dev-netinho/pdf-do-chatgpt/Pacoca_Prototipo_CAD_v1/step/corte_Y0_000.step

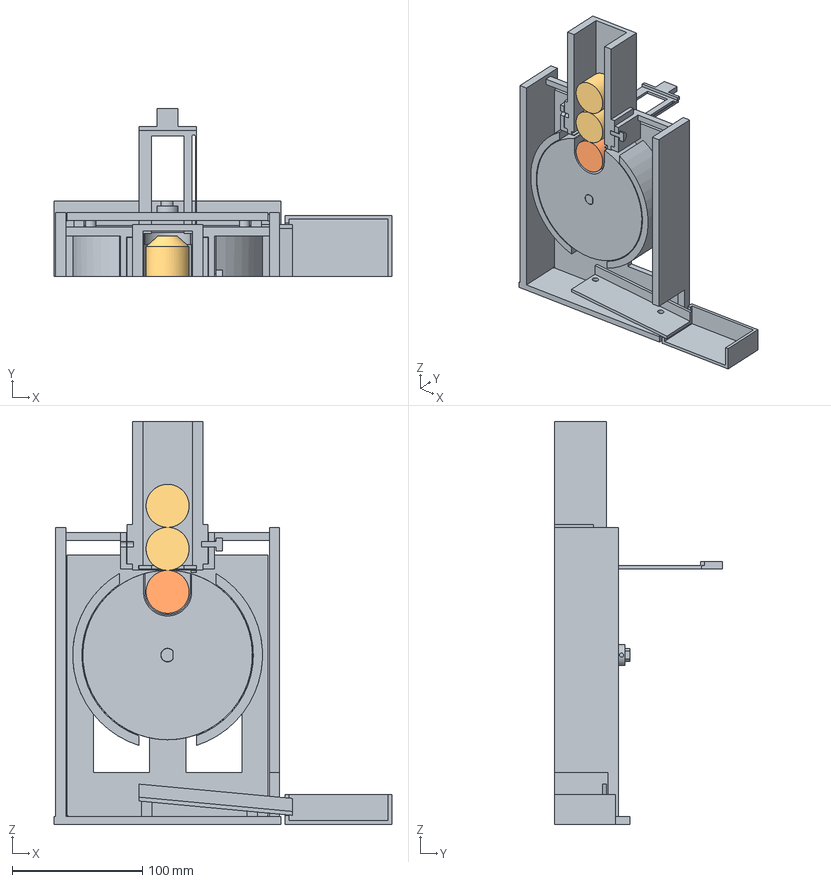
[picture p7: CAD file, 2026-10-01]
Pacoca_Prototipo_CAD_v1/step/corte_Y0_000.step
259.0 x 129.0 x 309.2 mm
04_roda_corte
01_cartucho_corte
02_comporta_U_corte
16_retencao_comporta_M2_corte
03_dock_corte
05_aro_fixo_corte
06_eixo_D_corte
12_colar_traseiro_corte
08_calha_corte
09_bandeja_corte
15_pino_cartucho_corte
REF_entrega_1_corte
REF_estoque_2_corte
REF_estoque_3_corte
