dev-netinho/pdf-do-chatgpt/Pacoca_Prototipo_CAD_v1/montagem_completa.step

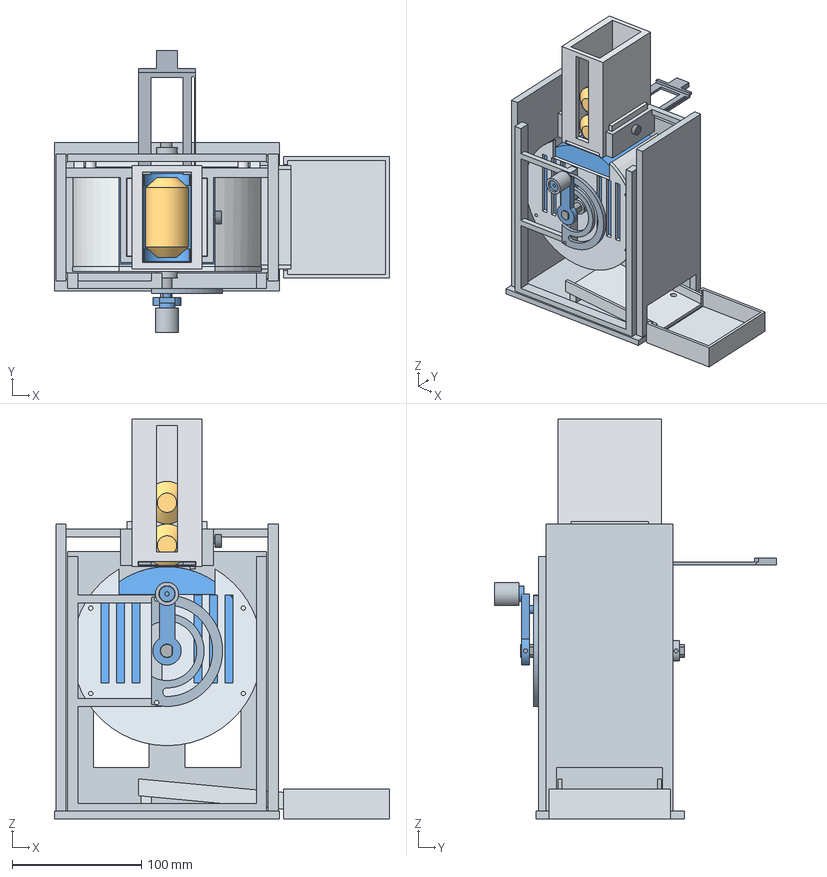
[picture p9: CAD file, 2026-10-01]
Pacoca_Prototipo_CAD_v1/montagem_completa.step
259.0 x 218.0 x 309.2 mm
04_roda
01_cartucho
02_comporta_U
16_retencao_comporta_M2
03_dock
05_aro_fixo
10_tampa_inspecao
06_eixo_D
11_colar_frontal
12_colar_traseiro
07_manivela
13_punho
14_batentes_0_180
08_calha
09_bandeja
15_pino_cartucho
REF_entrega_1
REF_estoque_2
REF_estoque_3
