dev-netinho/pdf-do-chatgpt/Pacoca_Prototipo_CAD_v1/step/09_bandeja.step

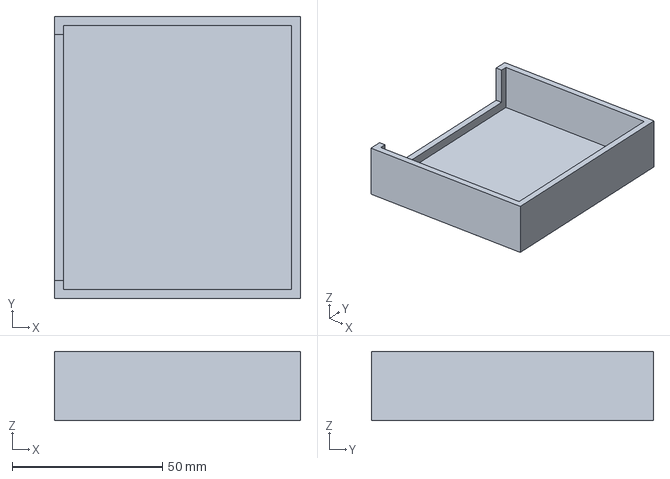
[picture p10: CAD file, 2026-10-01]
Pacoca_Prototipo_CAD_v1/step/09_bandeja.step
82.0 x 94.0 x 23.0 mm
