dev-netinho/pdf-do-chatgpt/Pacoca_Prototipo_CAD_v1/step/13_punho.step

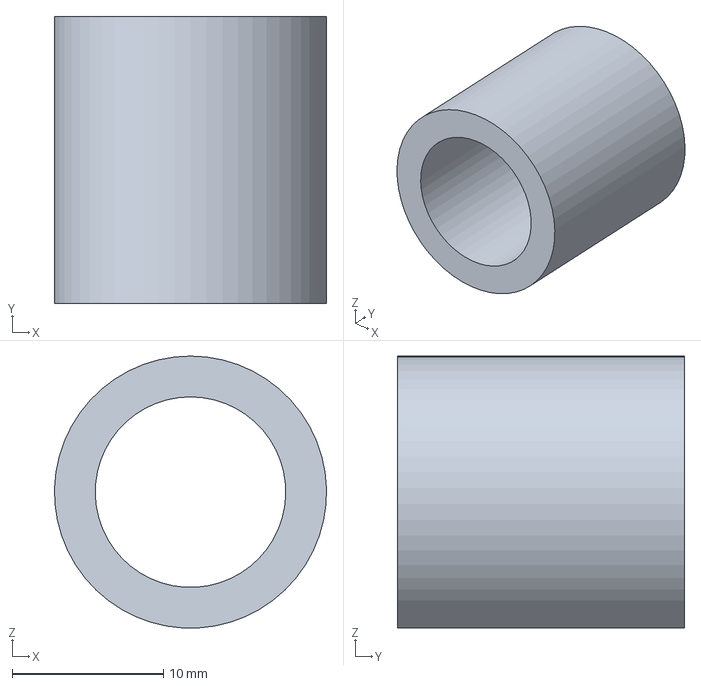
[picture p11: CAD file, 2026-10-01]
Pacoca_Prototipo_CAD_v1/step/13_punho.step
18.0 x 19.0 x 18.0 mm
