dev-netinho/pdf-do-chatgpt/Pacoca_Prototipo_CAD_v1/step/05_aro_fixo.step

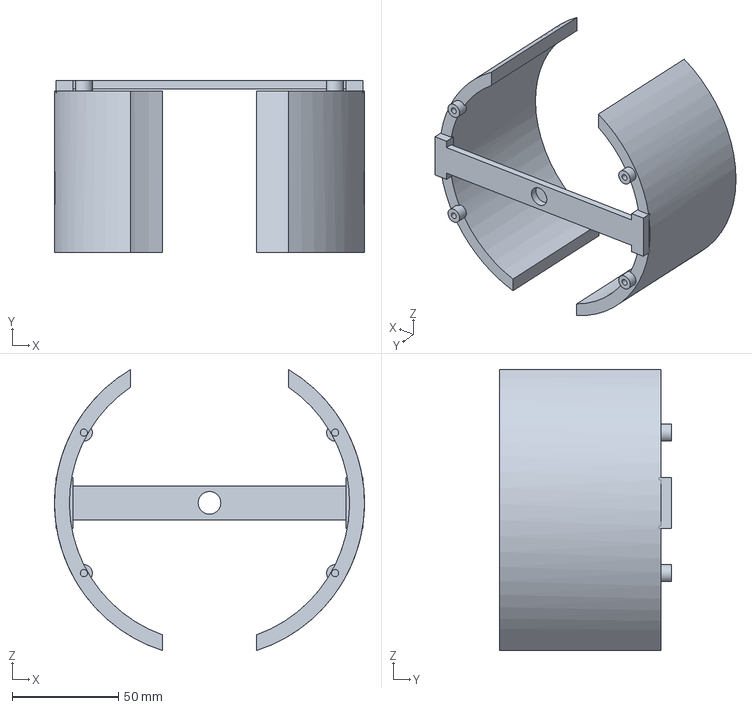
[picture p12: CAD file, 2026-10-01]
Pacoca_Prototipo_CAD_v1/step/05_aro_fixo.step
145.6 x 81.0 x 132.1 mm
