dev-netinho/pdf-do-chatgpt/Pacoca_Prototipo_CAD_v1/step/06_eixo_D.step

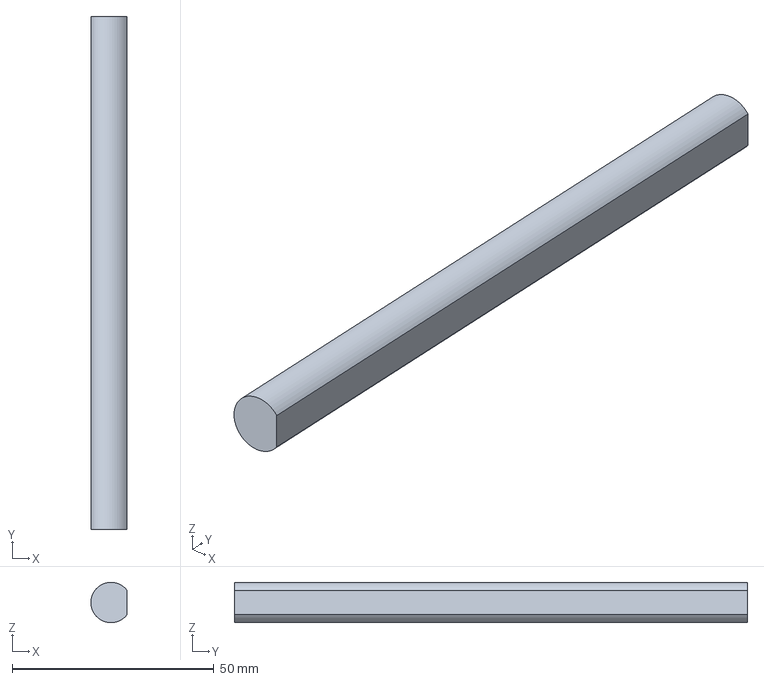
[picture p13: CAD file, 2026-10-01]
Pacoca_Prototipo_CAD_v1/step/06_eixo_D.step
9.00 x 127.0 x 9.99 mm
