dev-netinho/pdf-do-chatgpt/Pacoca_Prototipo_CAD_v1/step/11_colar_frontal.step

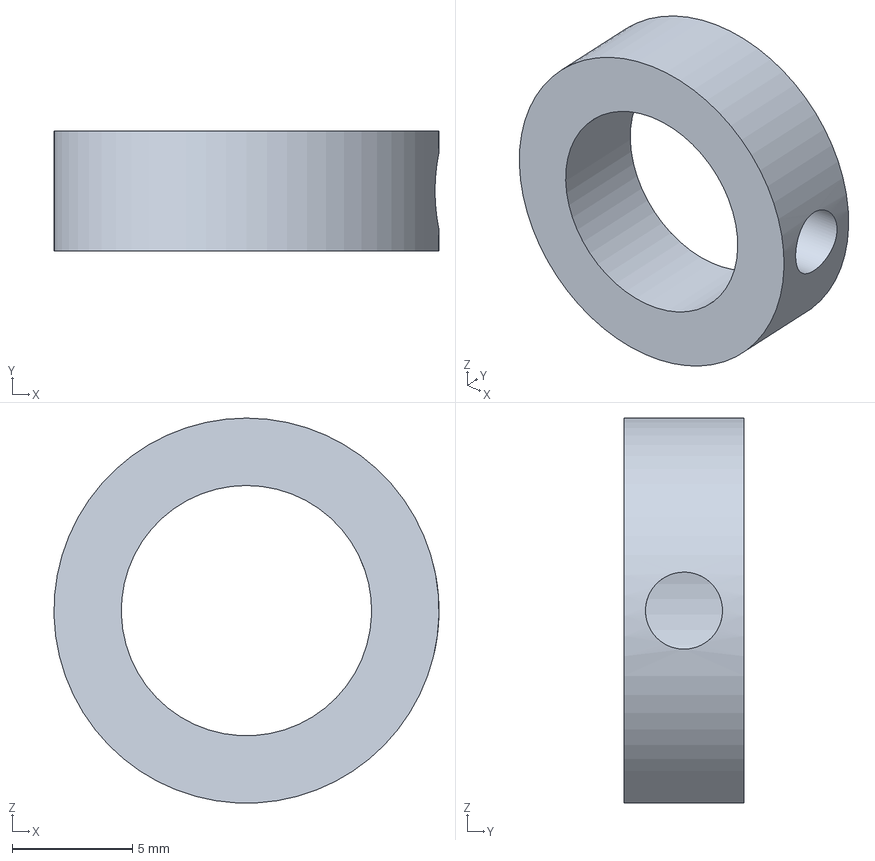
[picture p14: CAD file, 2026-10-01]
Pacoca_Prototipo_CAD_v1/step/11_colar_frontal.step
16.0 x 5.00 x 16.0 mm
