dev-netinho/pdf-do-chatgpt/Pacoca_Prototipo_CAD_v1/step/REF_espaco_futuro_motor.step

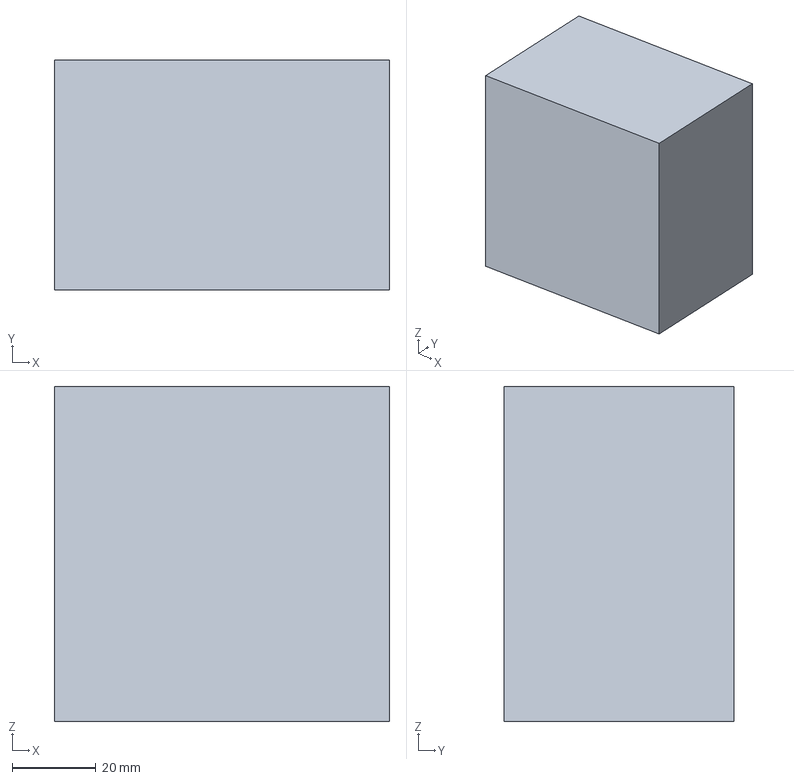
[picture p15: CAD file, 2026-10-01]
Pacoca_Prototipo_CAD_v1/step/REF_espaco_futuro_motor.step
80.0 x 55.0 x 80.0 mm
