dev-netinho/pdf-do-chatgpt/Pacoca_Prototipo_CAD_v1/step/16_retencao_comporta_M2.step

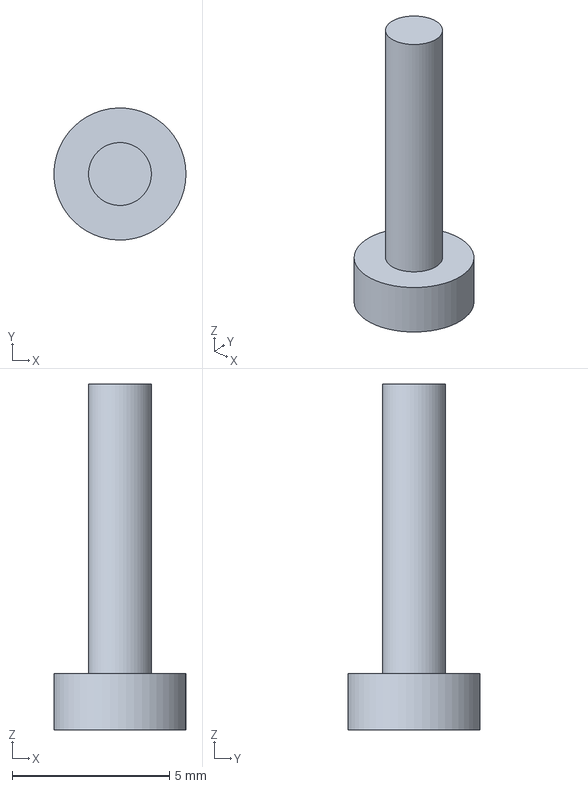
[picture p16: CAD file, 2026-10-01]
Pacoca_Prototipo_CAD_v1/step/16_retencao_comporta_M2.step
4.20 x 4.20 x 11.0 mm
