dev-netinho/pdf-do-chatgpt/Pacoca_Prototipo_CAD_v1/step/04_roda.step

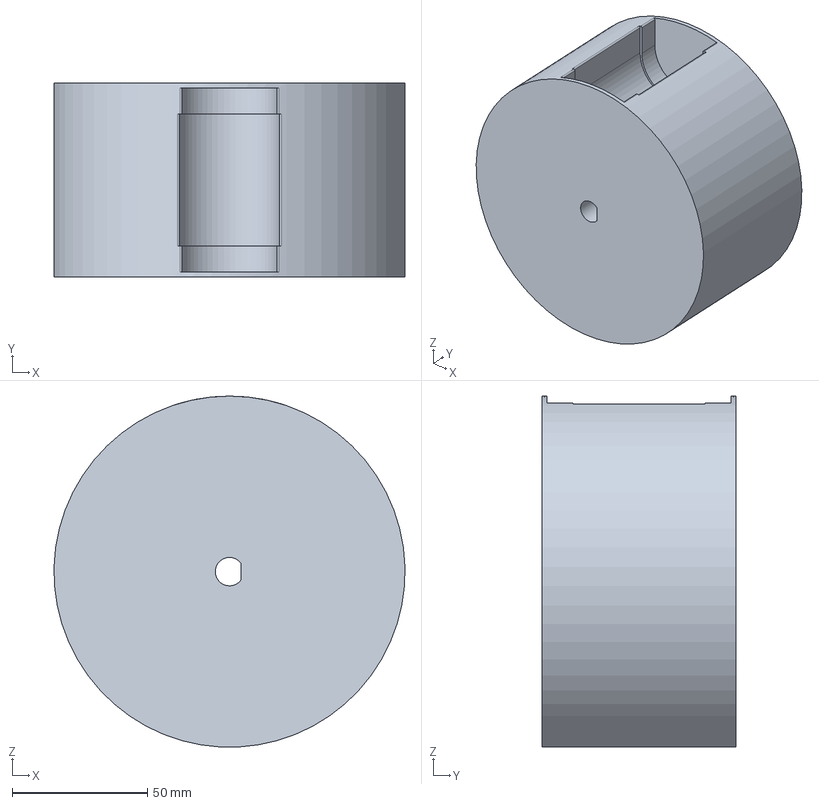
[picture p17: CAD file, 2026-10-01]
Pacoca_Prototipo_CAD_v1/step/04_roda.step
130.0 x 72.0 x 129.9 mm
