dev-netinho/pdf-do-chatgpt/Pacoca_Prototipo_CAD_v1/step/08_calha.step

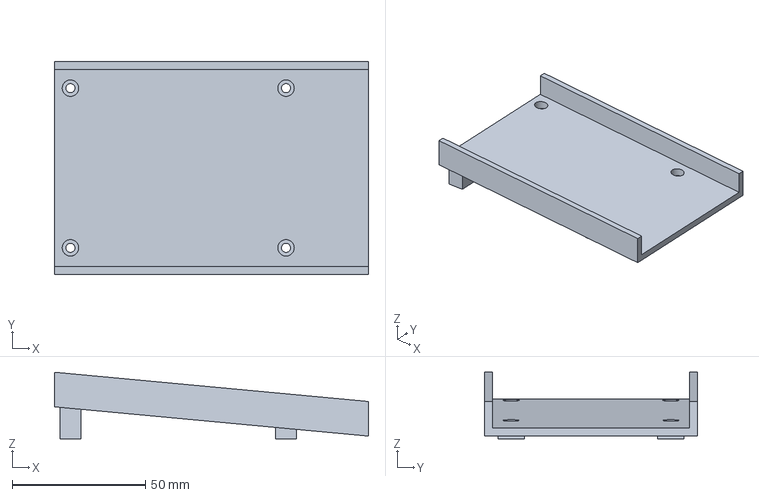
[picture p18: CAD file, 2026-10-01]
Pacoca_Prototipo_CAD_v1/step/08_calha.step
118.0 x 80.0 x 25.0 mm
