dev-netinho/pdf-do-chatgpt/Pacoca_Prototipo_CAD_v1/step/07_manivela.step

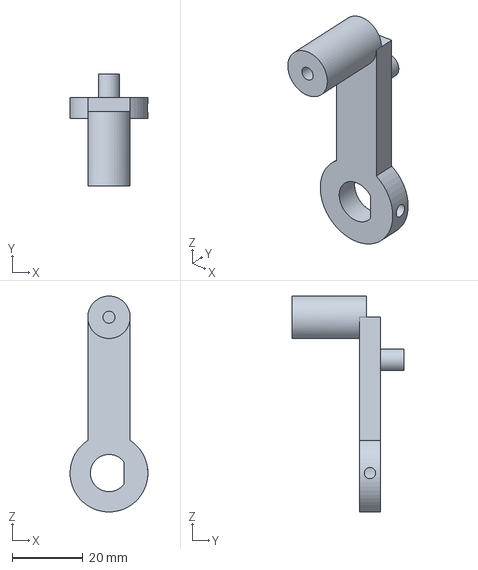
[picture p19: CAD file, 2026-10-01]
Pacoca_Prototipo_CAD_v1/step/07_manivela.step
22.0 x 31.6 x 61.0 mm
