dev-netinho/pdf-do-chatgpt/Pacoca_Prototipo_CAD_v1/step/14_batentes_0_180.step

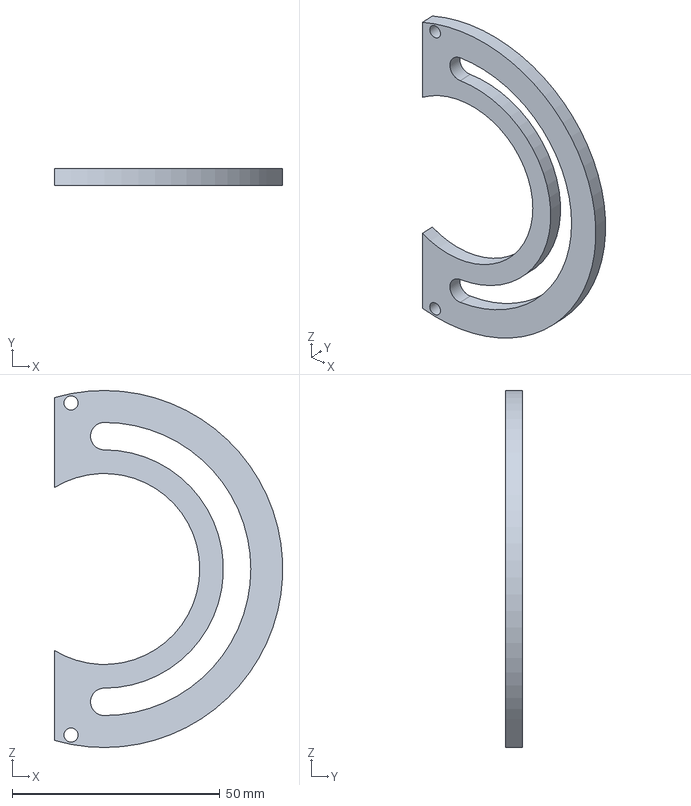
[picture p21: CAD file, 2026-10-01]
Pacoca_Prototipo_CAD_v1/step/14_batentes_0_180.step
55.0 x 4.00 x 86.0 mm
