dev-netinho/pdf-do-chatgpt/Pacoca_Prototipo_CAD_v1/step/02_comporta_U.step

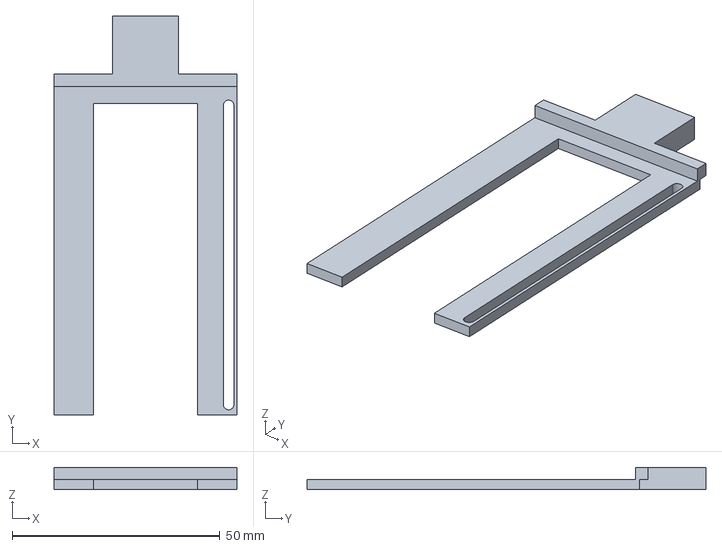
[picture p23: CAD file, 2026-10-01]
Pacoca_Prototipo_CAD_v1/step/02_comporta_U.step
44.0 x 96.0 x 5.40 mm
