dev-netinho/pdf-do-chatgpt/Pacoca_Prototipo_CAD_v1/step/03_dock.step

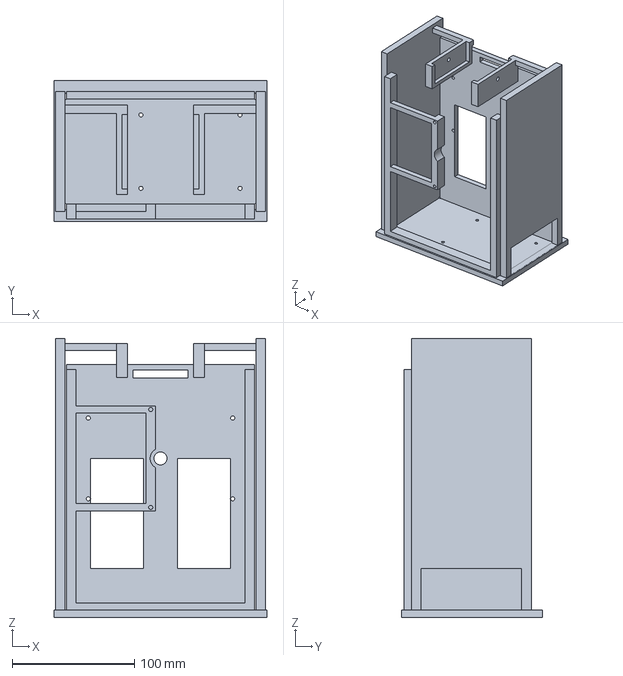
[picture p24: CAD file, 2026-10-01]
Pacoca_Prototipo_CAD_v1/step/03_dock.step
174.0 x 115.0 x 228.0 mm
