dev-netinho/pdf-do-chatgpt/Pacoca_Prototipo_CAD_v1/step/01_cartucho.step

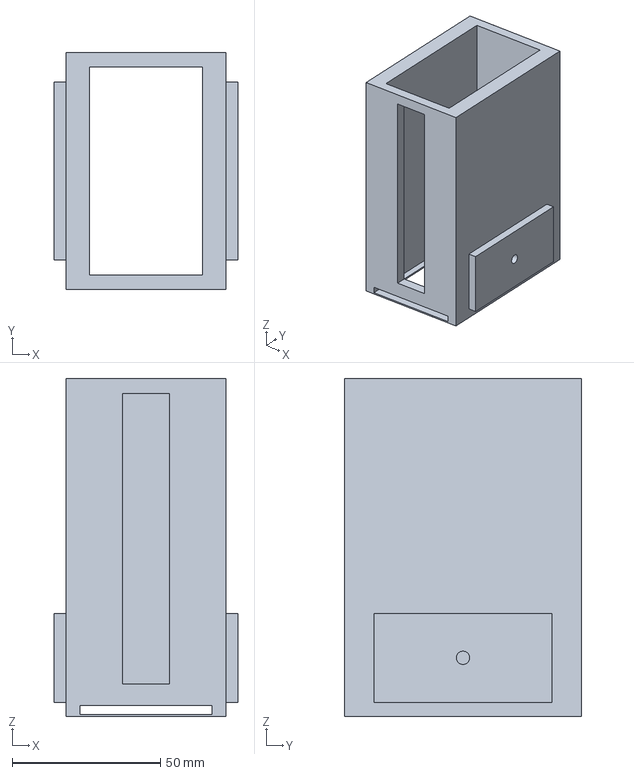
[picture p25: CAD file, 2026-10-01]
Pacoca_Prototipo_CAD_v1/step/01_cartucho.step
62.0 x 80.0 x 114.0 mm
