dev-netinho/pdf-do-chatgpt/Pacoca_Prototipo_CAD_v1/step/10_tampa_inspecao.step

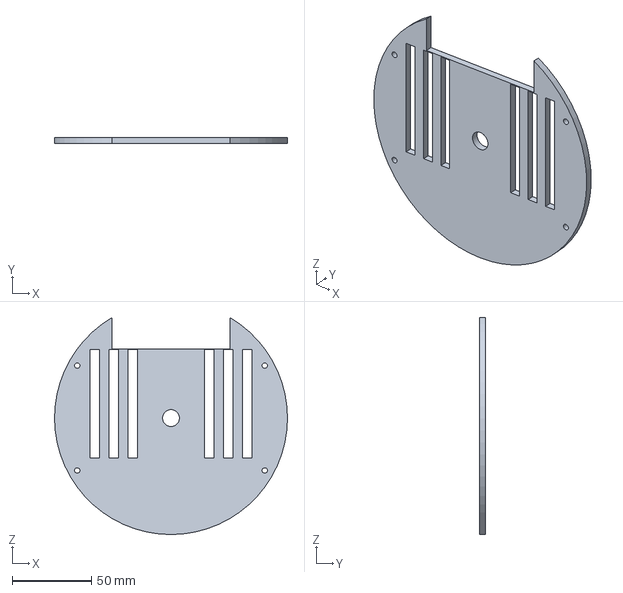
[picture p26: CAD file, 2026-10-01]
Pacoca_Prototipo_CAD_v1/step/10_tampa_inspecao.step
146.6 x 4.00 x 136.6 mm
