dev-netinho/pdf-do-chatgpt/Pacoca_Prototipo_CAD_v1/step/15_pino_cartucho.step

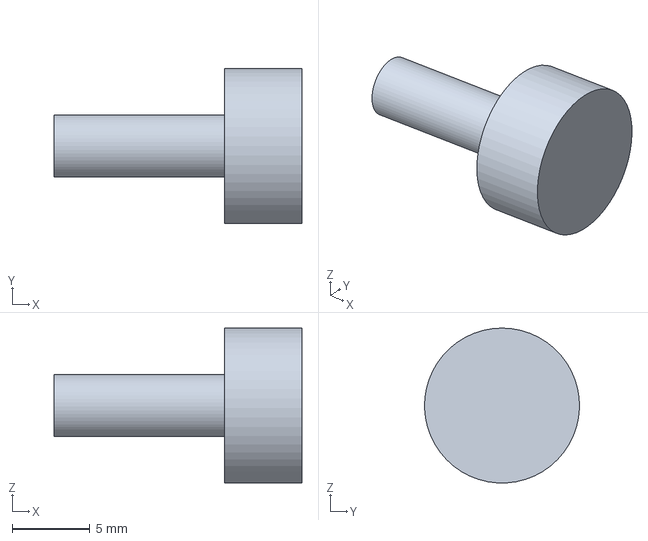
[picture p27: CAD file, 2026-10-01]
Pacoca_Prototipo_CAD_v1/step/15_pino_cartucho.step
16.0 x 10.00 x 9.99 mm
