dev-netinho/pdf-do-chatgpt/(list of files, cad)

Other CAD files:
Pacoca_Prototipo_CAD_v1/step/02_carga_0_montagem.step
Pacoca_Prototipo_CAD_v1/step/12_colar_traseiro.step
Pacoca_Prototipo_CAD_v1/step/04b_retorno_vazio_000.step
Pacoca_Prototipo_CAD_v1/step/06_segunda_entrega_180_montagem.step
Pacoca_Prototipo_CAD_v1/step/04b_retorno_vazio_025.step
Pacoca_Prototipo_CAD_v1/step/05_segunda_carga_0_montagem.step
Pacoca_Prototipo_CAD_v1/step/05b_recarga_intermediaria_gravidade.step
Pacoca_Prototipo_CAD_v1/step/04_entrega_180_montagem.step
Pacoca_Prototipo_CAD_v1/step/03_giro_90_montagem.step
Pacoca_Prototipo_CAD_v1/step/corte_Y0_090.step
Pacoca_Prototipo_CAD_v1/step/04b_retorno_vazio_090.step
Pacoca_Prototipo_CAD_v1/stl/01_cartucho.stl
Pacoca_Prototipo_CAD_v1/stl/02_comporta_U.stl
Pacoca_Prototipo_CAD_v1/stl/03_dock.stl
Pacoca_Prototipo_CAD_v1/stl/04_roda.stl
Pacoca_Prototipo_CAD_v1/stl/05_aro_fixo.stl
Pacoca_Prototipo_CAD_v1/stl/06_eixo_D.stl
Pacoca_Prototipo_CAD_v1/stl/07_manivela.stl
Pacoca_Prototipo_CAD_v1/stl/08_calha.stl
Pacoca_Prototipo_CAD_v1/stl/09_bandeja.stl
Pacoca_Prototipo_CAD_v1/stl/10_tampa_inspecao.stl
Pacoca_Prototipo_CAD_v1/stl/11_colar_frontal.stl
Pacoca_Prototipo_CAD_v1/stl/12_colar_traseiro.stl
Pacoca_Prototipo_CAD_v1/stl/13_punho.stl
Pacoca_Prototipo_CAD_v1/stl/14_batentes_0_180.stl
Pacoca_Prototipo_CAD_v1/stl/15_pino_cartucho.stl
Pacoca_Prototipo_CAD_v1/stl/16_retencao_comporta_M2.stl
